zsf90/ClockLED/PCB/ClockLED_ONE.xlsx

Comment | Designator | Footprint | Value | Quantity
用户按钮 | B1, B2, B3, B4 | SW-SMD_L6.0-W3.5-LS8.0 |  | 4
复位按钮 | B5, B6 | SW-SMD_L6.0-W3.5-LS8.0 |  | 2
3V | BT1 | BAT-SMD_CR1220-2 |  | 1
Cap | C1, C2 | C0603 | 20pF | 2
Cap | C3, C5, C6, C9, C14, C16 | C0603 | 104 | 6
Cap | C4 | C1812 | 10uF | 1
Cap | C7 | C1206 | 1uF | 1
Cap | C8 | C1210 | 10uF | 1
Cap | C10, C11 | C1210 | 20uF | 2
Cap | C12 | C0603 | 10uF | 1
Cap Pol1 | C13, C15 | CASE-A_3216 | 10uF | 2
D4148 | D1 | SOD-80_L3.5-W1.5-RD |  | 1
D Schottky | D2 | SMA_L4.4-W2.8-LS5.4-RD |  | 1
M7 | D3 | SOD-123_L2.8-W1.8-LS3.7-RD |  | 1
EC11 | E1 | EC11 |  | 1
500mA | F1 | F0603 |  | 1
Fuse 1 | F2 | F0603 |  | 1
VS1838B | IR1 | HS0038 |  | 1
Inductor | L1 | IND-SMD_L6.0-W6.0_SWPA6045S | 6.8uH 3A | 1
LED | LED1, LED2 | LED0603_RED |  | 2
LS7525 | LS1 | BUZ-SMD_4P-7525 |  | 1
SWD | P1 | IDC-SMD-10P-1.27MM |  | 1
SWD | P2 | HDR1X4-Male |  | 1
HDR-M-2.54-1x4 | P3 | HDR1X4-Male |  | 1
电池+ | PAD1 | PAD_1 |  | 1
电池- | PAD2 | PAD_1 |  | 1
S9013 | Q1, Q3 | SOT-23-3_L2.9-W1.6-P1.90-LS2.8-BR |  | 2
DS18B20 | Q2 | TO-92A |  | 1
Res | R1, R2, R4, R7, R8, R9, R12, R13, R16, R24 | R0603 | 10K | 10
Res | R3 | R0603 | 0 | 1
Res | R5, R10 | R0603 | 1K | 2
Res | R6 | R0603 | 10 | 1
Res | R11, R14, R15, R17 | R0603 | 4.7K | 4
Res_EU | R18 | R0805 | 0.5 | 1
Res_EU | R19 | R0603 | 10K | 1
Res_EU | R20 | R0603 | 1K | 1
Res | R21 | R0603 | 73.2K | 1
Res | R22, R23 | R0603 | 510 | 2
Res | R25 | R0603 | 2K | 1
Circuit Breaker | SB1, SB2, SB3 | JP2_SMD |  | 3
7-SEG-GYSZ | SEG1 | 7-SEG-GY0_8INCH |  | 1
Test | T1, T2 | TEST-SMD |  | 2
GD32F130F8P6TR | U1 | TSSOP-20-N |  | 1
AIP1637 | U2 | SOP-20_L12.8-W7.5-P1.27-LS10.4-BL |  | 1
DS1302 | U3 | SOIC-8_208mil_L5.3-W5.3-P1.27-LS8.0-BL |  | 1
TP4065 | U4 | SOT-23-5L |  | 1
SX1308 | U5 | SOT-23-6_L2.9-W1.6-P0.95-LS2.8-BR |  | 1
AMS1117-3.3 | U6 | SOT-223_L6.7-W3.5-P2.30-BR |  | 1
TYPE-C-6P | USB1 | USB-C-SMD_6P |  | 1
8MHz | Y1 | HC-49 |  | 1
32.768KHz | Y2 | CRYSTAL-SMD_BD2.0-L6.0-P2.54-32.768 |  | 1
