zsf90/ClockLED/CAD3D/0.8寸数码管.SLDPRT

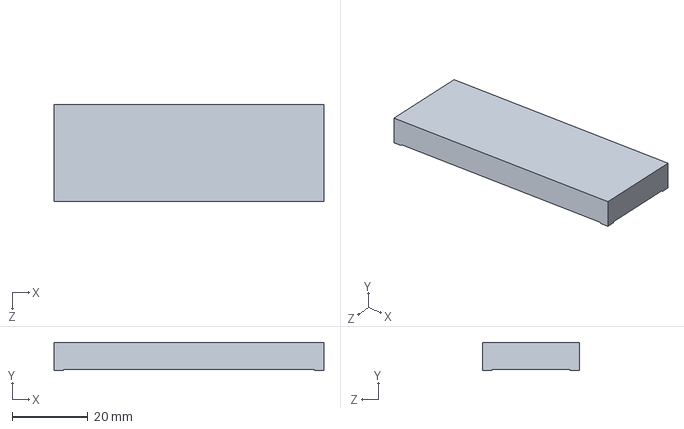
[picture p1: CAD file, 2022-03-15]
CAD3D/0.8寸数码管.SLDPRT
71.5 x 7.50 x 25.7 mm
