zsf90/ClockLED/PCB/ClockLED_ONE.pdf

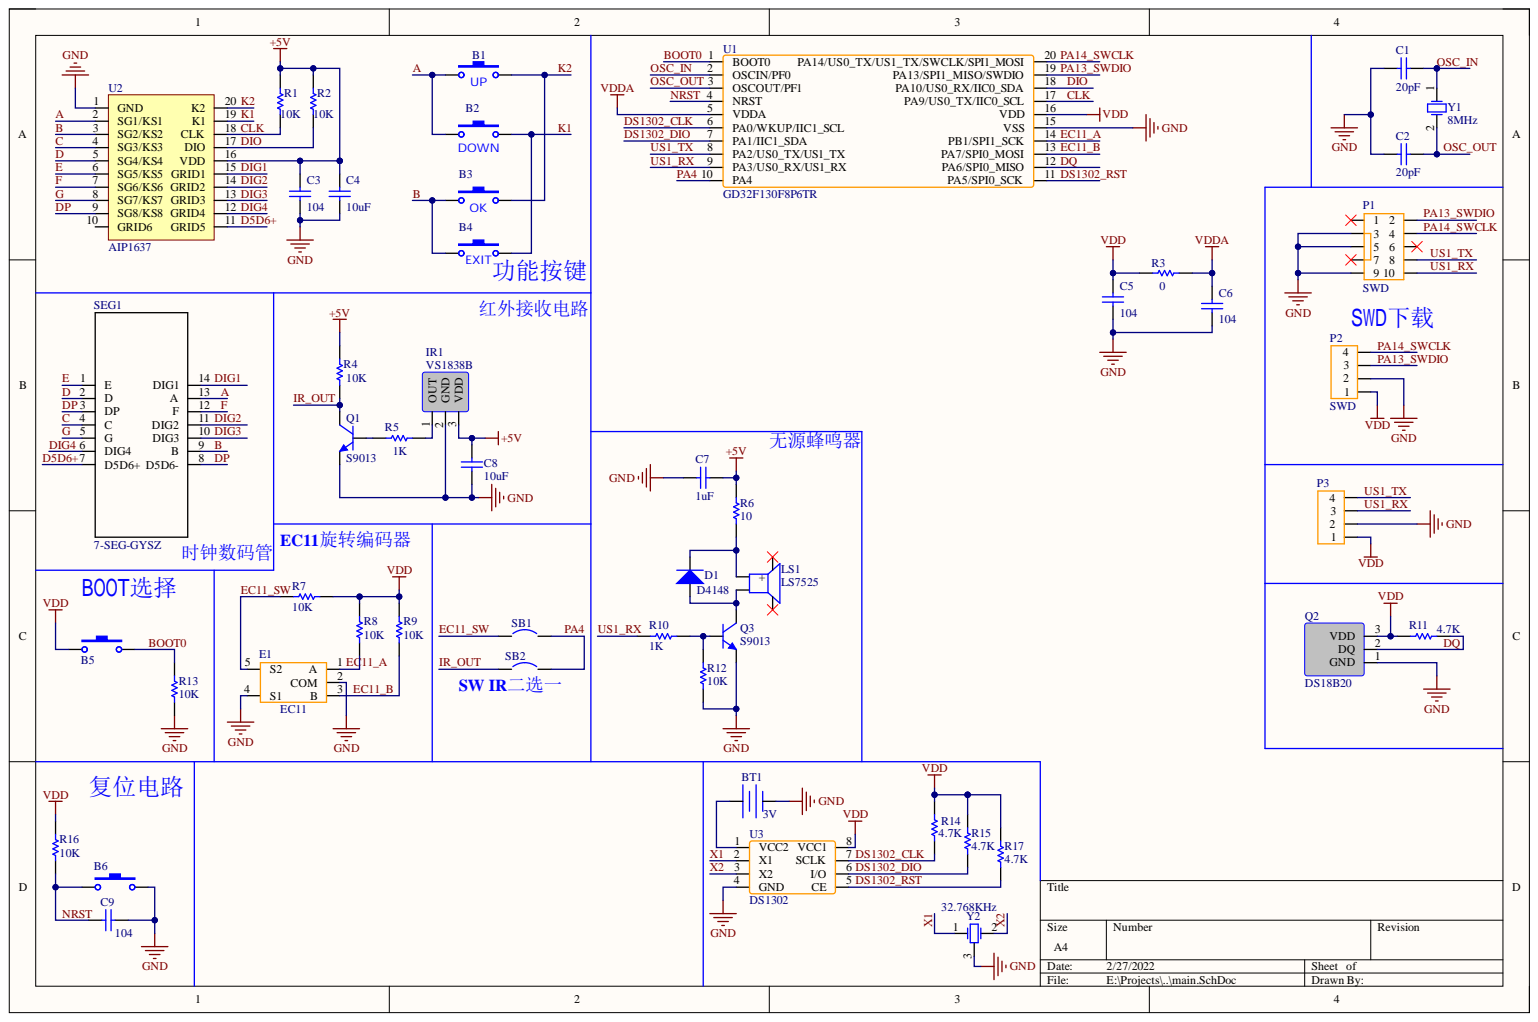
[picture p2: page 1]

S2 5 | COM
S1 4 | | 2

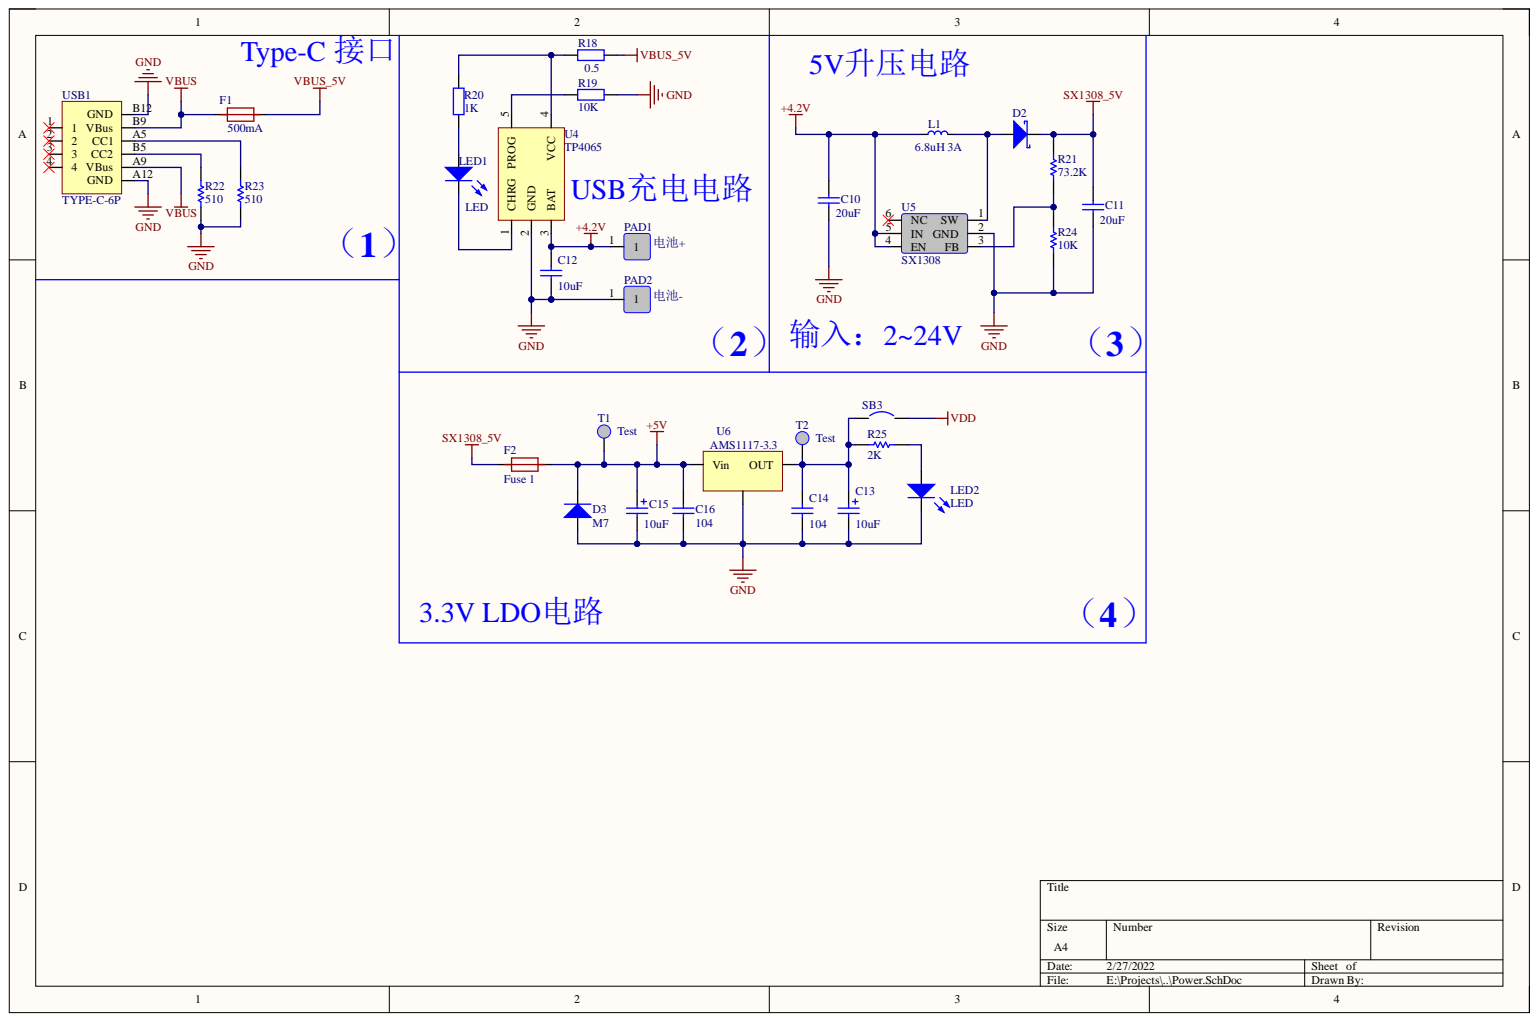
[picture p3: page 2]

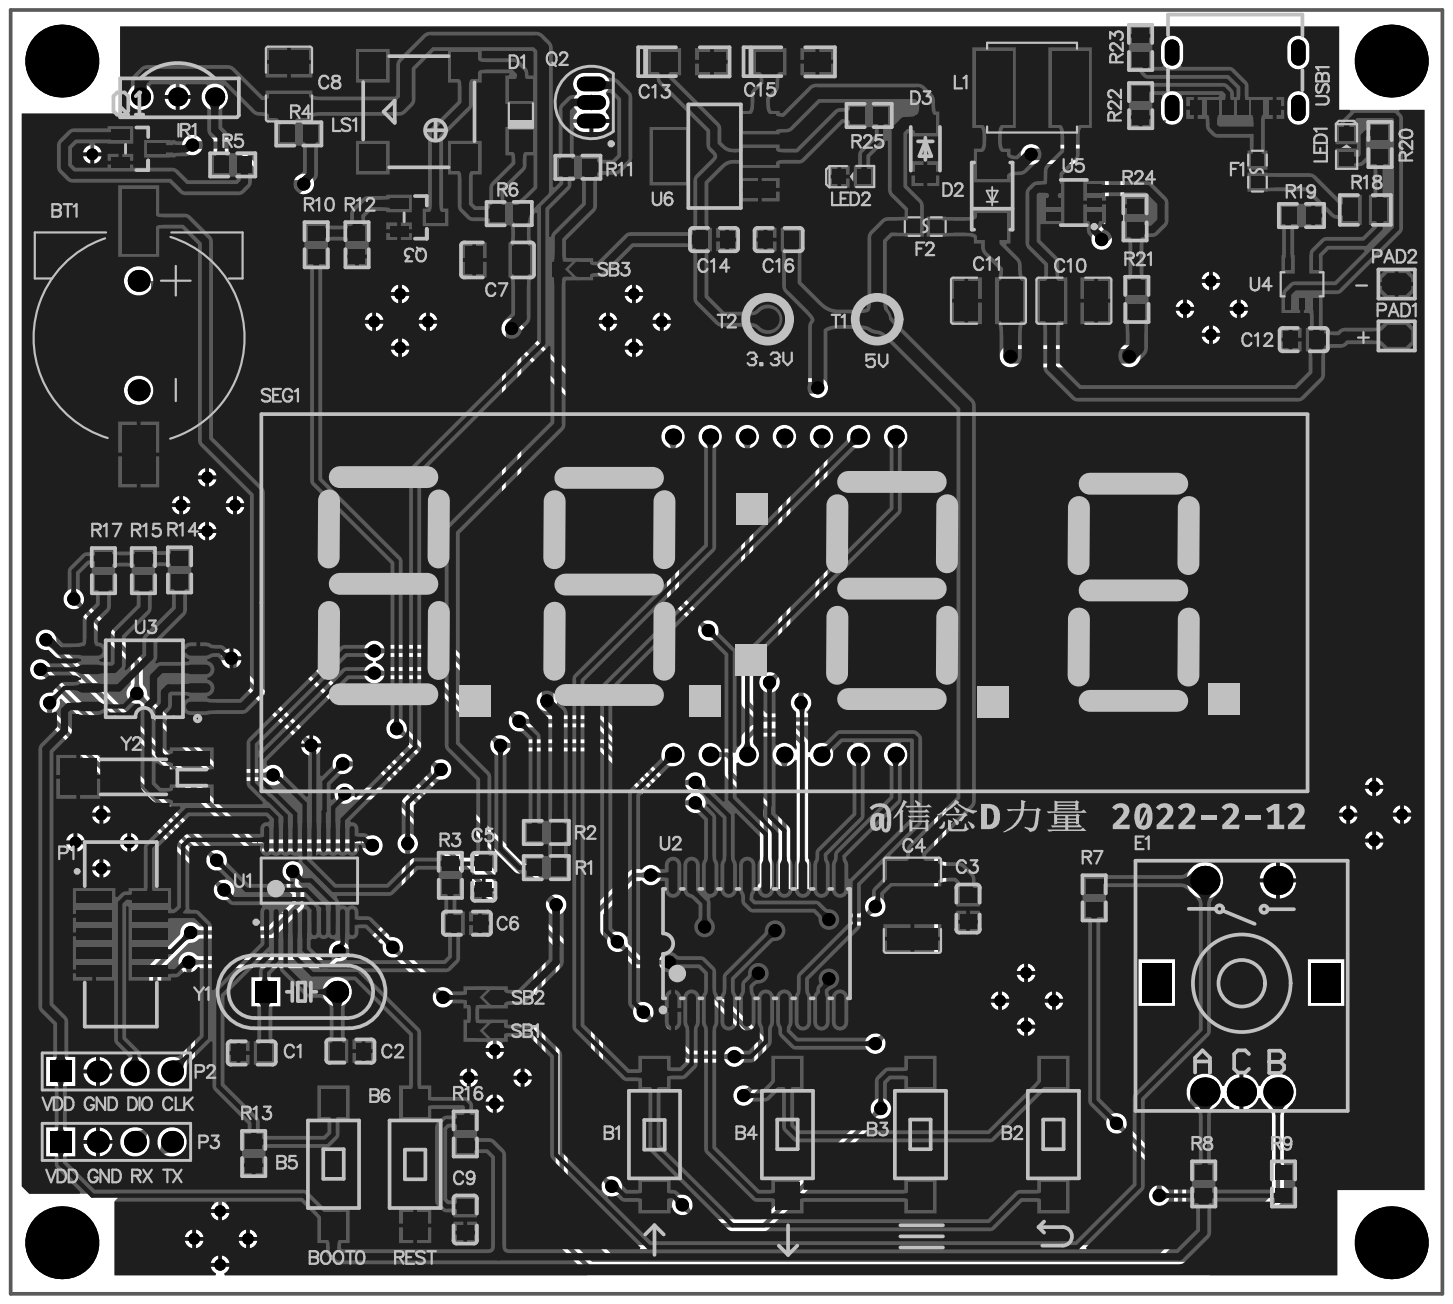
[picture p4: page 3]
