zsf90/ClockLED/(list of files, drawings)

Other design files:
PCB/ClockLED_ONE.PrjPcb
PCB/Src/main.SchDoc
PCB/Src/Power.SchDoc
