zsf90/ClockLED/(commit log)

2022-03-15 初次提交
    [0.8寸数码管.SLDPRT, ClockLED_ONE.PrjPcb, ClockLED_ONE.xlsx, Power.SchDoc, main.SchDoc]
2022-03-17 第二次提交
2022-03-20 添加功能
2022-03-21 添加旋转编码器调整时间代码
2022-03-22 完善 DS1302 始终程序
2022-03-28 添加 flash代码
2022-04-03 Flash 更新
2022-04-04 添加蜂鸣器代码和完善Flash系统参数存储功能
